cosmic-pi-deprecated/MainBoard-hardware/README.md

# MainBoard-hardware
Mainboard for Arduino DUE based versions
