cosmic-pi-deprecated/MainBoard-hardware/ProductionBOM Cosmic Pi Main Board 181017.xlsx

Qty | Value | Parts | Package | Tolerance | Wattage | Voltage Rating | Manufacturer | MPN | Description | Device | Side | Mounting
1 | 22-23-2051 | 22-23-2051 | H5-2.54 |  |  |  | Harwin | M20-9990546 | 5 Pin 2.54mm pitch male header |  | Top | TH
1 | 0 | R1 | R0603 | 1% | 0.1W |  |  |  | RESISTOR, European symbol | R-EU_R0603 | Bottom | SMD
1 | 10 | R2 | R0603 | 1% | 0.1W |  |  |  | RESISTOR, European symbol | R-EU_R0603 | Bottom | SMD
6 | 100k | R11, R12, R37, R38, R41, R42 | R0603 | 1% | 0.1W |  |  |  | RESISTOR, European symbol | R-EU_R0603 | Bottom | SMD
18 | 100n | C3, C4, C5, C7, C12, C13, C14, C15, C16, C18, C21, C23, C29, C33, C35, C38, C41, C42 | C0603 | 10% |  | 100 |  |  | CAPACITOR, European symbol | C-EUC0603 | Bottom | SMD
10 | 10k | R4, R5, R9, R10, R24, R34, R35, R36, R39, R40 | R0603 | 1% | 0.1W |  |  |  | RESISTOR, European symbol | R-EU_R0603 | Bottom | SMD
8 | 10n | C6, C11, C17, C25, C26, C27, C36, C39 | C0603 | 10% |  | 10 |  |  | CAPACITOR, European symbol | C-EUC0603 | Bottom | SMD
2 | 10u | C9, C10 | C0603 | 10% |  |  |  |  | CAPACITOR, European symbol | C-EUC0603 | Bottom | SMD
2 | 150uH | L2, L9 | L1812 |  |  |  | Bourns | CM453232-151KL | INDUCTOR, European symbol | L-EUL1812 | Bottom | SMD
2 | 15k | R18, R32 | R0603 | 1% | 0.1W |  |  |  | RESISTOR, European symbol | R-EU_R0603 | Bottom | SMD
8 | 1M | R13, R14, R15, R21, R25, R26, R27, R30 | R0603 | 1% | 1/16W |  |  |  | RESISTOR, European symbol | R-EU_R0603 | Bottom | SMD
4 | 1n | C28, C34, C43, C44 | C0603 | 10% |  | 10 |  |  | CAPACITOR, European symbol | C-EUC0603 | Bottom | SMD
2 | 1u | C20, C32 | C0603 | -20/+80% |  | 10 |  |  | CAPACITOR, European symbol | C-EUC0603 | Bottom | SMD
2 | 200k | R23, R33 | R0603 | 5% | 1/16W |  |  |  | RESISTOR, European symbol | R-EU_R0603 | Bottom | SMD
5 | 220n | C19, C22, C30, C37, C40 | C0603 | 10% |  | 10 |  |  | CAPACITOR, European symbol | C-EUC0603 | Bottom | SMD
2 | 24.9k | R19, R29 | R0603 | 1% | 0.2W |  |  | ERJP03F24R9V | RESISTOR, European symbol | R-EU_R0603 | Bottom | SMD
2 | 32.4k | R22, R31 | R0603 | 1% | 0.1W |  |  | ERJ3EKF3242V | RESISTOR, European symbol | R-EU_R0603 | Bottom | SMD
4 | 330R | R3, R6, R7, R8 | R0603 | 5% | 1/16W |  |  |  | RESISTOR, European symbol | R-EU_R0603 | Bottom | SMD
1 | 4.7u | C8 | C0603 | 10% |  | 10 |  |  | CAPACITOR, European symbol | C-EUC0603 | Bottom | SMD
2 | 40 | R16, R17 | R0603 | 5% | 1/16W |  |  | ERJ3EKF40R2V | RESISTOR, European symbol | R-EU_R0603 | Bottom | SMD
2 | 47n | C24, C31 | C0603 | 10% |  | 100 |  | C1608X7S2A473K080AB | CAPACITOR, European symbol | C-EUC0603 | Bottom | SMD
1 | 47nH | L1 | INDC1608X90N |  |  |  | EPCOS | B82496C3470J000 | INDUCTOR, 47NH 270MA 5% | B82496C3470J | Bottom | SMD
2 | 4p-2.54 | J1, J2 | H4-2.54 |  |  |  | Harwin | M20-7820446 | 320030017 | DIP-BLACK-FEMALE-HEADER-VERT(4P-2.54) | Top | SMD
1 | 5-1814400-1 | J5 | TE_5-1814400-1 |  |  |  | TE Connectivity | 5-1814400-1 | Conn SMA RCP 0Hz to 3GHz 50Ohm Solder RA Thru-Hole Gold Over Nickel Over Copper | 5-1814400-1 | Top | TH
5 | 600R/100MHz | L4, L5, L6, L7, L8 | 1206 |  |  |  | Wurth | 74279218 | SMD EMI Suppression Ferrite Beads WE-CBF | WE-CBF-74279218_1206 | Bottom | SMD
3 | 74AUC1G00DBV | IC1, IC5, IC6 | SOT23-5 |  |  |  | Texas Instruments | SN74AHCT1G00DBVR | 2-input NAND gate | 74AUC1G00DBV | Bottom | SMD
2 | 806 | R20, R28 | R0603 | 1% | 0.1W |  | Farnell | 2670898 | RESISTOR, European symbol | R-EU_R0603 | Bottom | SMD
2 | BAT46WH | BAT46WH1, BAT46WH2 | SOD123F |  |  |  | Nexperia | BAT46WH | Single Schottky barrier diodeSingle planar Schottky barrier diode with an integrated guard ring for stress protection, | BAT46WH | Bottom | SMD
2 | BSS123 | Q1, Q2 | SOT23 |  |  |  | Diodes Zetex | BSS123-7-F | N-CHANNEL MOS FET | BSS123 | Bottom | SMD
1 | DUE(NORMAL) | DUE1 | DUE(NORMAL) |  |  |  | Harwin | 5 of M20-9990845, 1 of M20-9991046 | Note - this 'part is actually 6 sets of pin headers for the Arduino DUE. The 40 pin header is omitted. | DUE(NORMAL) | Bottom | TH
1 | L-710A8GE/1I1GD-RV | D1 | 2X02 |  |  |  | Kingbright | L-710A8GE/1I1GD-RV | PIN HEADER | KINGBRITET1 | Top | TH
1 | L76-M33 | U1 | CAPCAV110P970X1010X250-18N |  |  |  | Quectel | L76-M33 | GPS Receiver 1575.42MHz 2.5V/3.3V 18-Pin | L76-M33 | Bottom | SMD
3 | LM555D | IC2, IC3, IC4 | SO08 |  |  |  | Texas Instruments | TLC555ID | TIMER | LM555D | Bottom | SMD
1 | LPS25H | IC$1 | LPS25H |  |  |  | ST Micro | LPS25HBTR | ST-Micro Piezoresistive pressure sensor | LPS25H | Bottom | SMD
1 | LSM303D | U2 | LGA16L |  |  |  | ST Micro | LSM303DTR |  | LSM303D | Bottom | SMD
2 | MAX1932 | U5, U6 | TQFN-12 |  |  |  | Maxim | MAX1932ETC+ |  | MAX1932 | Bottom | SMD
1 | MAX991ESA+ | IC$3 | SOIC-8 |  |  |  | Maxim | MAX991ESA+ |  | MAX991ESA+ | Bottom | SMD
1 | SI7006A20 | IC$2 | 3X3DFN |  |  |  | Silicon Labs | Si7006-A20-IM |  | SI7006A20 | Bottom | SMD
120 | Total
91 | SMD
11 | TH
4 | Packages with concealed pads
84 | Passives
