cosmic-pi-deprecated/MainBoard-hardware/Cosmic Pi Main Board V2.5 OHL no logo.pdf

A

A

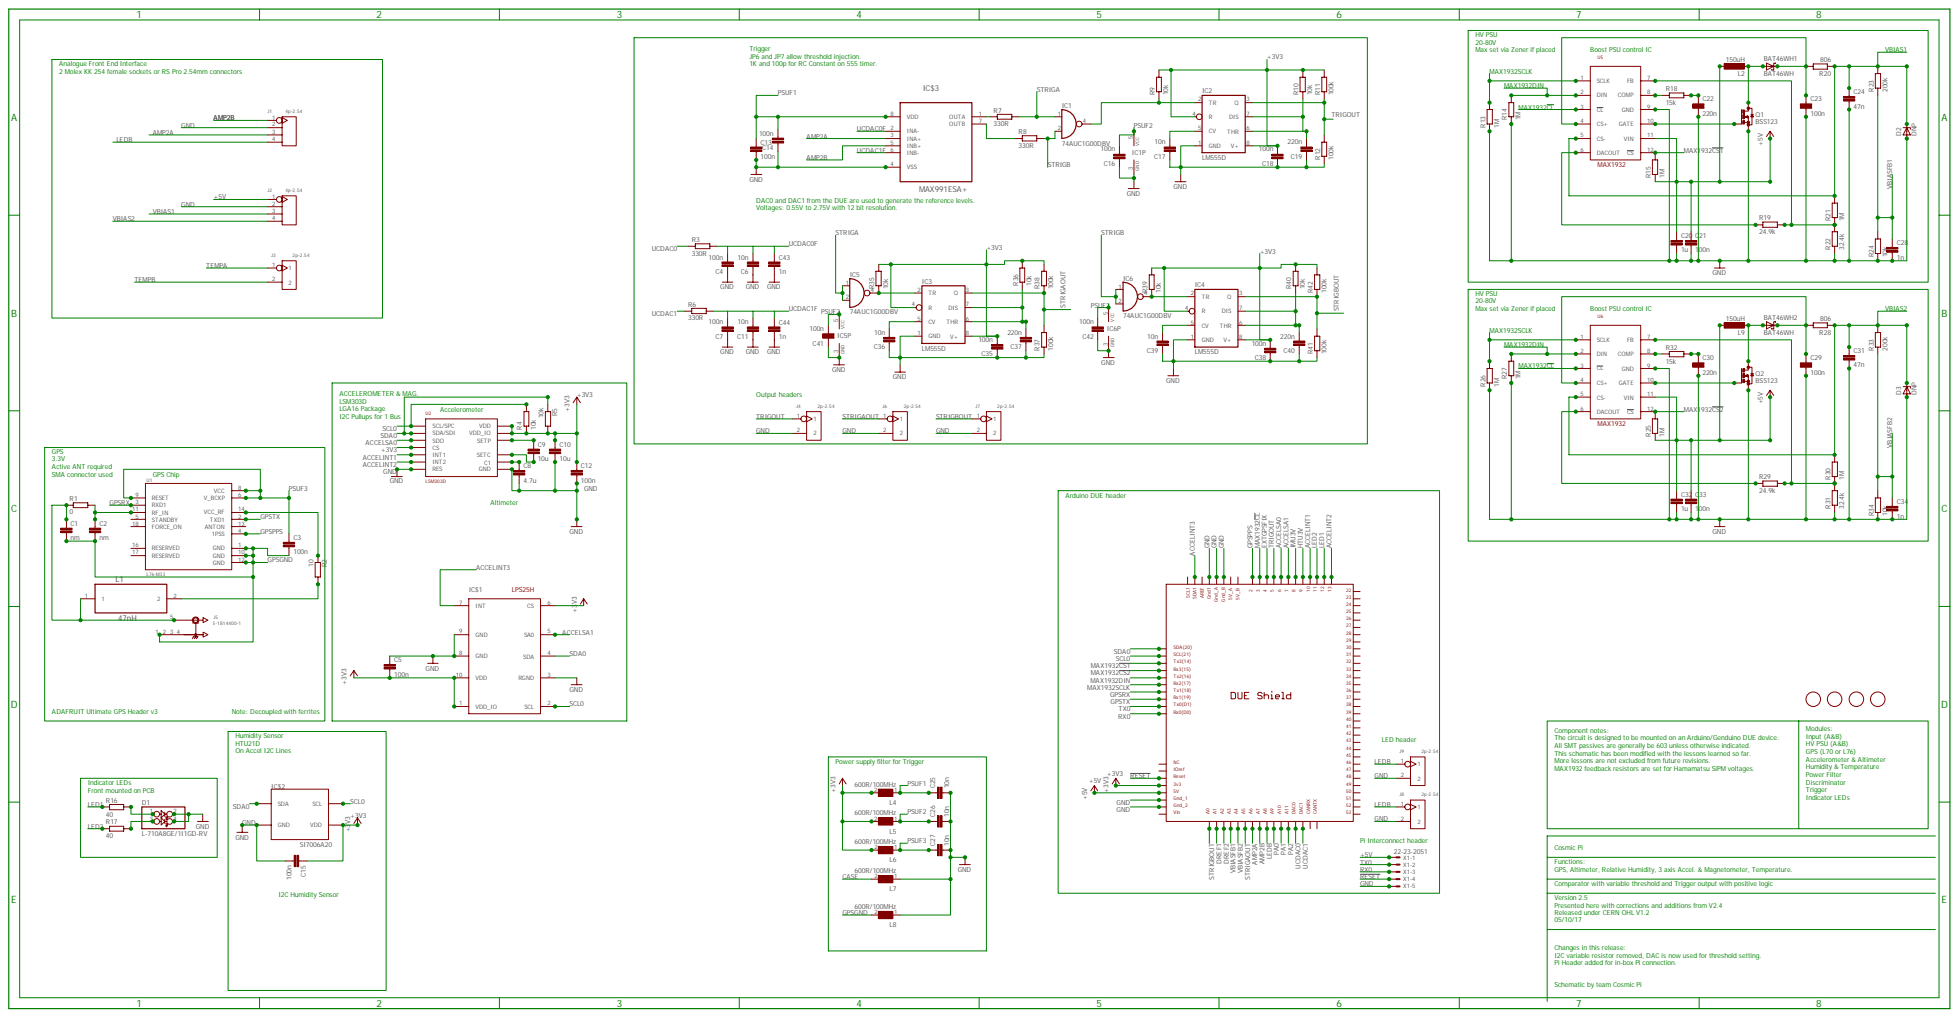
[picture p1: page 1]

HV PSU
Max set via Zener if placed

Trigger
JP6 and JP7 allow threshold injection.
1K and 100p for RC Constant on 555 timer.

Boost PSU control IC

Analogue Front End Interface
2 Molex KK 254 female sockets or RS Pro 2.54mm connectors

DAC0 and DAC1 from the DUE are used to generate the reference levels.
Voltages: 0.55V to 2.75V with 12 bit resolution.

ADAFRUIT Ultimate GPS Header v3

Note: Decoupled with ferrites

Component notes:
The circuit is designed to be mounted on an Arduino/Genduino DUE device.
All SMT passives are generally be 603 unless otherwise indicated.
This schematic has been modified with the lessons learned so far.
More lessons are not excluded from future revisions.
MAX1932 feedback resistors are set for Hamamatsu SiPM voltages.

Power supply filter for Trigger

Cosmic Pi
Functions:
GPS, Altimeter, Relative Humidity, 3 axis Accel. & Magnetometer, Temperature.
Comparator with variable threshold and Trigger output with positive logic
Version 2.5
Presented here with corrections and additions from V2.4
Released under CERN OHL V1.2

Changes in this release:
I2C variable resistor removed, DAC is now used for threshold setting.
Pi Header added for in-box Pi connection.

Schematic by team Cosmic Pi
