cosmic-pi-deprecated/MainBoard-hardware/Cosmic Pi Main Board V2.5 OHL no logo.brd

## EAGLE design Cosmic Pi Main Board V2.5 OHL no logo.brd (2017-10-26)

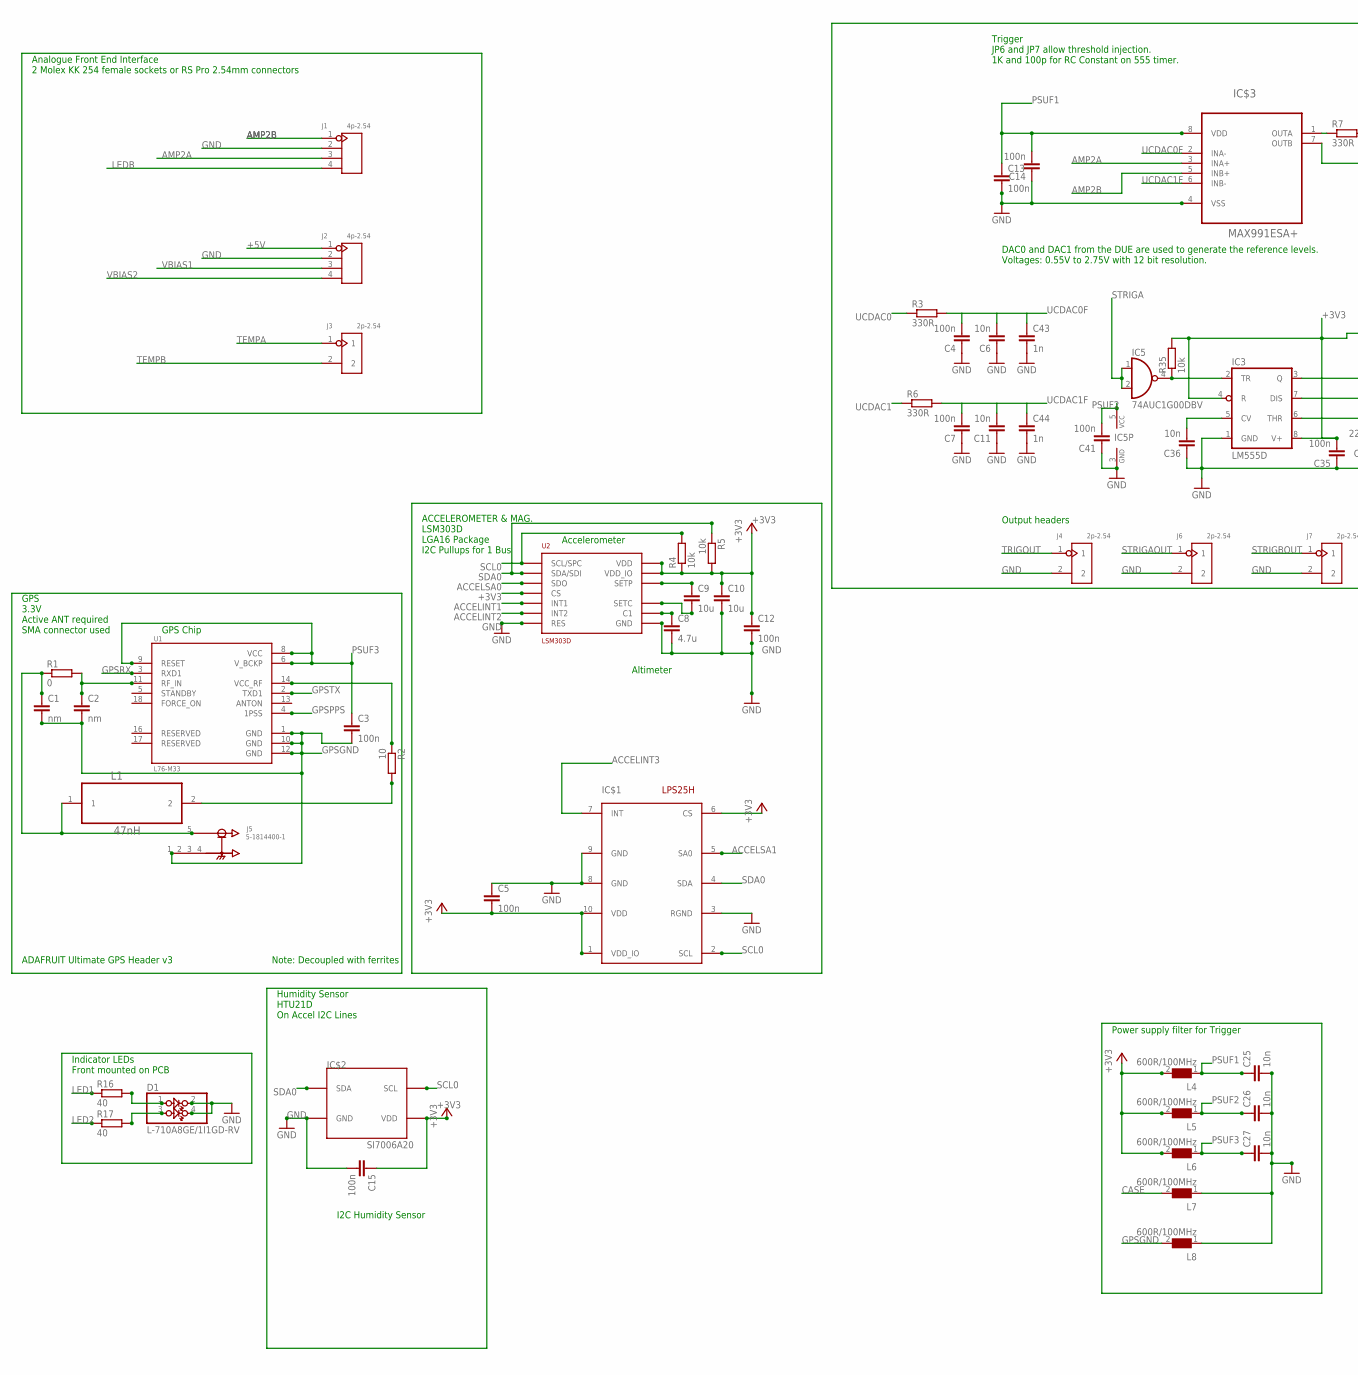
[picture p2: schematic Cosmic Pi Main Board V2.5 OHL no logo.sch, part in row 1, column 1]

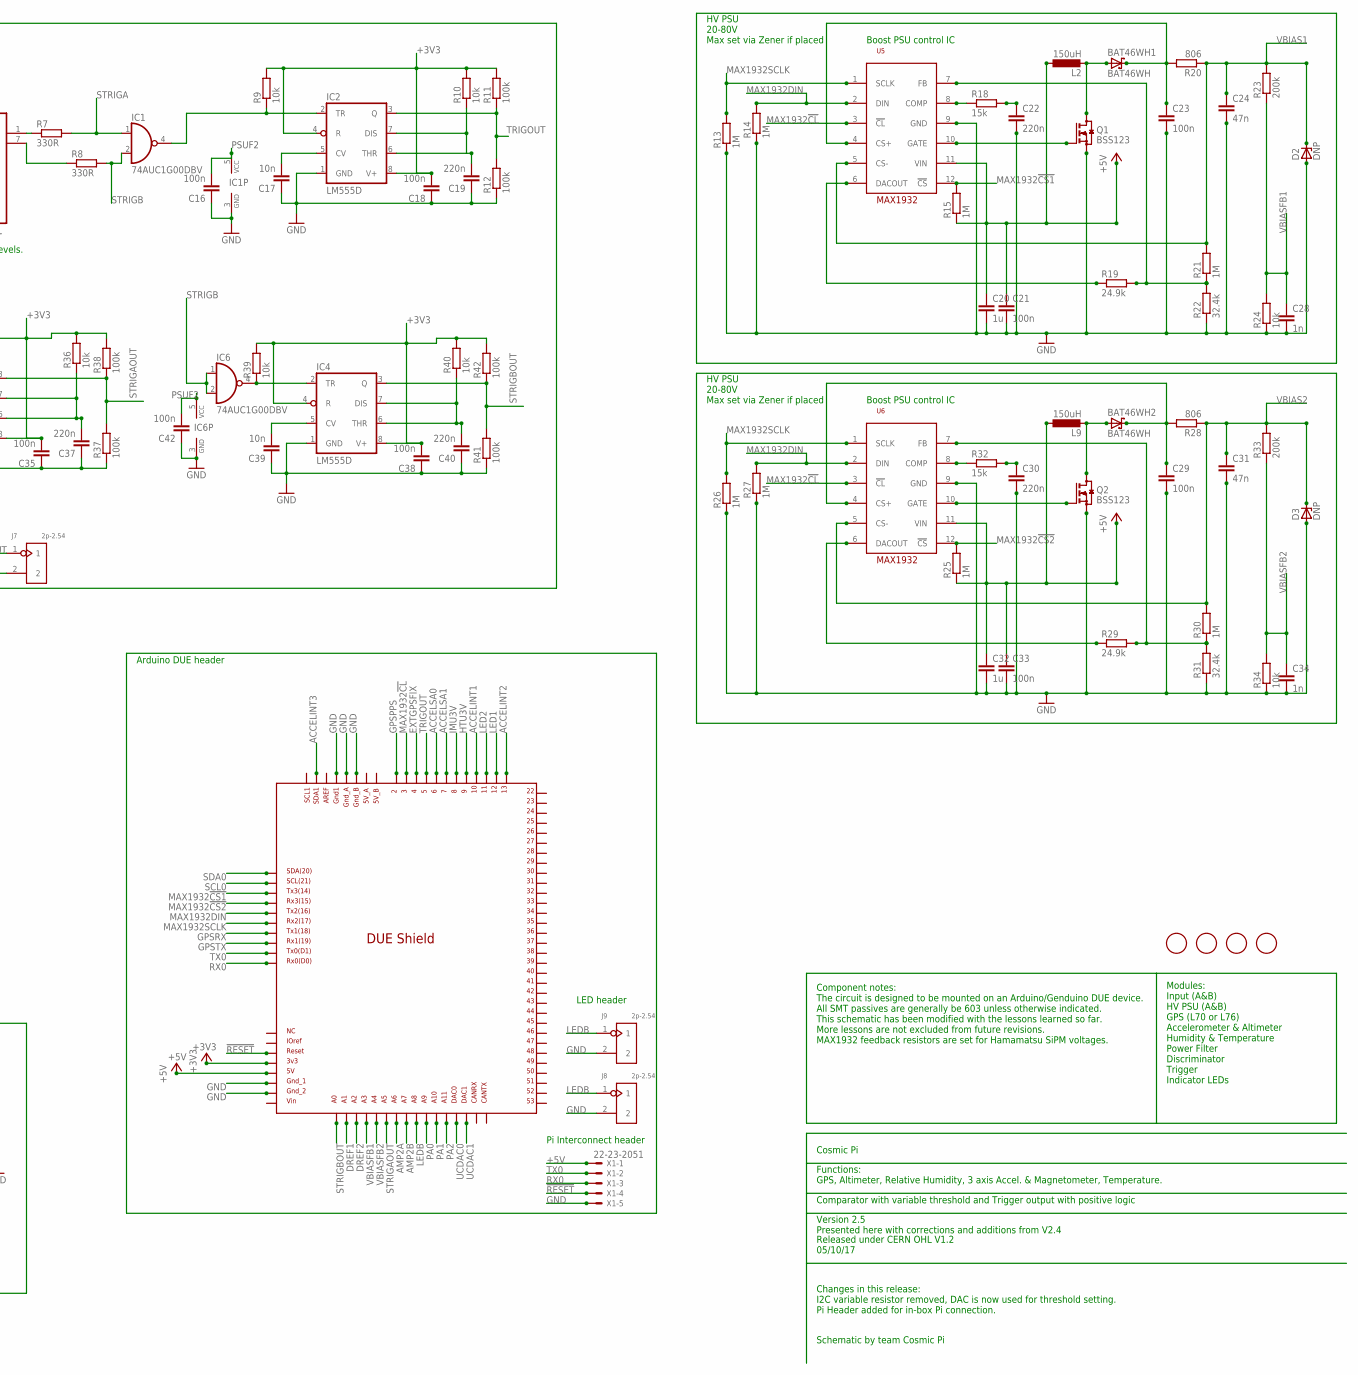
[picture p3: schematic Cosmic Pi Main Board V2.5 OHL no logo.sch, part in row 1, column 2]

Parts:
BAT46WH1, BAT46WH2: BAT46WH; SOD123F
C1, C2: nm; C0603
C3, C4, C5, C7, C12, C13, C14, C15, C16, C18, C21, C23, C29, C33, C35, C38, C41, C42: 100n; C0603
C6, C11, C17, C25, C26, C27, C36, C39: 10n; C0603
C8: 4.7u; C0603
C9, C10: 10u; C0603
C19, C22, C30, C37, C40: 220n; C0603
C20, C32: 1u; C0603
C24, C31: 47n; C0603
C28, C34, C43, C44: 1n; C0603
D1: L-710A8GE/1I1GD-RV; 2X02
D2, D3: DNP; SOT23
DUE1: DUE(NORMAL)
IC1, IC5, IC6: 74AUC1G00DBV; SOT23-5
IC2, IC3, IC4: LM555D; SO08
IC$1: LPS25H
IC$2: SI7006A20; 3X3DFN
IC$3: MAX991ESA+; SOIC-8
J1, J2: 4p-2.54; H4-2.54
J3, J4, J6, J7, J8, J9: 2p-2.54; H2-2.54
J5: 5-1814400-1; TE_5-1814400-1
L1: 47nH; INDC1608X90N
L2, L9: 150uH; L1812
L4, L5, L6, L7, L8: 600R/100MHz; 1206
Q1, Q2: BSS123; SOT23
R1: 0; R0603
R2: 10; R0603
R3, R6, R7, R8: 330R; R0603
R4, R5, R9, R10, R24, R34, R35, R36, R39, R40: 10k; R0603
R11, R12, R37, R38, R41, R42: 100k; R0603
R13, R14, R15, R21, R25, R26, R27, R30: 1M; R0603
R16, R17: 40; R0603
R18, R32: 15k; R0603
R19, R29: 24.9k; R0603
R20, R28: 806; R0603
R22, R31: 32.4k; R0603
R23, R33: 200k; R0603
U1: L76-M33; CAPCAV110P970X1010X250-18N
U2: LSM303D; LGA16L
U5, U6: MAX1932; TQFN-12
U$1, U$2, U$3, U$4: FIDUCIAL; FIDUCIAL_1MM
X1: 22-23-2051

Connections:
!RESET: DUE1.RESET, X1.4
+3V3: C5.2, C10.1, C12.1, C15.1, C18.2, C35.2, C38.2, DUE1.3V3, IC2.4 (R), IC2.8 (V+), IC3.4 (R), IC3.8 (V+), IC4.4 (R), IC4.8 (V+), IC$1.1 (VDD_IO), IC$1.6 (CS), IC$1.10 (VDD), IC$2.P$5 (VDD), L4.2, L5.2, L6.2, R4.1, R5.2, R9.2, R10.2, R11.2, R35.2, R36.2, R38.2, R39.2, R40.2, R42.2, U2.P$1 (VDD_IO), U2.P$8 (CS), U2.P$14 (VDD)
+5V: C20.1, C21.1, C32.1, C33.1, DUE1.5V, J2.1, L2.1, L9.1, R15.1, R25.1, U5.11 (VIN), U6.11 (VIN), X1.1
ACCELINT1: DUE1.10, U2.P$11 (INT1)
ACCELINT2: DUE1.13, U2.P$9 (INT2)
ACCELINT3: DUE1.SDA1, IC$1.7 (INT)
ACCELSA0: DUE1.6, U2.P$7 (SDO)
ACCELSA1: DUE1.7, IC$1.5 (SA0)
AMP2A: DUE1.A6, IC$3.3 (INA+), J1.3
AMP2B: DUE1.A7, IC$3.5 (INB+), J1.1
CASE: L7.2
DREF1: DUE1.A1
DREF2: DUE1.A2
EXTGPSFIX: DUE1.4
GND: C4.1, C5.1, C6.1, C7.1, C8.2, C10.2, C11.1, C12.2, C13.2, C14.1, C15.2, C16.1, C17.1, C18.1, C19.1, C20.2, C21.2, C22.2, C23.2, C24.2, C25.2, C26.2, C27.2, C28.2, C29.2, C30.2, C31.2, C32.2, C33.2, C34.2, C35.1, C36.1, C37.1, C38.1, C39.1, C40.1, C41.1, C42.1, C43.2, C44.2, D1.2, D1.4, D2.1 (A), D3.1 (A), DUE1.GND1, DUE1.GND_1, DUE1.GND_2, DUE1.GND_A, DUE1.GND_B, IC1.3 (GND), IC2.1 (GND), IC3.1 (GND), IC4.1 (GND), IC5.3 (GND), IC6.3 (GND), IC$1.3 (RGND), IC$1.8 (GND), IC$1.9 (GND), IC$2.P$2 (GND), IC$3.4 (VSS), J1.2, J2.2, J4.2, J6.2, J7.2, J8.2, J9.2, L7.1, L8.1, Q1.2 (S), Q2.2 (S), R12.1, R13.1, R14.1, R22.1, R24.1, R26.1, R27.1, R31.1, R34.1, R37.1, R41.1, U2.P$5 (GND), U2.P$10 (RES), U2.P$12 (GND), U2.P$13 (GND), U2.P$16 (GND), U5.9 (GND), U6.9 (GND), X1.5
GPSGND: C1.2, C2.2, C3.2, J5.1 (GND), L8.2, U1.1 (GND), U1.10 (GND), U1.12 (GND)
GPSPPS: DUE1.2, U1.4 (1PSS)
GPSRX: DUE1.TX1, U1.3 (RXD1)
GPSTX: DUE1.RX1, U1.2 (TXD1)
HTU3V: DUE1.9
IMU3V: DUE1.8
LED1: DUE1.12, R16.1
LED2: DUE1.11, R17.1
LEDB: DUE1.A8, J1.4, J8.1, J9.1
MAX1932!CL: DUE1.3, U5.3 (!CL), U6.3 (!CL)
MAX1932!CS1: DUE1.TX3, R15.2, U5.12 (!CS)
MAX1932!CS2: DUE1.RX3, R25.2, U6.12 (!CS)
MAX1932DIN: DUE1.TX2, R14.2, R27.2, U5.2 (DIN), U6.2 (DIN)
MAX1932SCLK: DUE1.RX2, R13.2, R26.2, U5.1 (SCLK), U6.1 (SCLK)
unnamed: IC$3.1 (OUTA), R7.1
unnamed: IC$3.7 (OUTB), R8.1
unnamed: C17.2, IC2.5 (CV)
unnamed: C19.2, IC2.6 (THR), IC2.7 (DIS), R10.1
unnamed: C36.2, IC3.5 (CV)
unnamed: Q2.1 (G), U6.10 (GATE)
unnamed: BAT46WH2.2 (A), L9.2, Q2.3 (D)
unnamed: BAT46WH2.1 (K), C29.1, R28.2, U6.4 (CS+)
unnamed: R29.1, U6.6 (DACOUT)
unnamed: R32.1, U6.8 (COMP)
unnamed: C30.1, R32.2
unnamed: R29.2, R30.1, R31.2, U6.7 (FB)
unnamed: C37.2, IC3.6 (THR), IC3.7 (DIS), R36.1
unnamed: IC1.4 (O), IC2.2 (TR), R9.1
unnamed: Q1.1 (G), U5.10 (GATE)
unnamed: C39.2, IC4.5 (CV)
unnamed: C40.2, IC4.6 (THR), IC4.7 (DIS), R40.1
unnamed: IC4.2 (TR), IC6.4 (O), R39.1
unnamed: IC3.2 (TR), IC5.4 (O), R35.1
unnamed: BAT46WH1.2 (A), L2.2, Q1.3 (D)
unnamed: BAT46WH1.1 (K), C23.1, R20.2, U5.4 (CS+)
unnamed: R19.2, R21.1, R22.2, U5.7 (FB)
unnamed: C1.1, J5.5 (SIG), L1.1, R1.1
unnamed: R19.1, U5.6 (DACOUT)
unnamed: R18.1, U5.8 (COMP)
unnamed: C22.1, R18.2
unnamed: C9.1, U2.P$3 (SETP)
unnamed: C9.2, U2.P$2 (SETC)
unnamed: C8.1, U2.P$15 (C1)
unnamed: L1.2, R2.2
unnamed: R2.1, U1.14 (VCC_RF)
unnamed: C2.1, R1.2, U1.11 (RF_IN)
unnamed: D1.1, R16.2
unnamed: D1.3, R17.2
PA0: DUE1.A9
PA1: DUE1.A10
PA2: DUE1.A11
PSUF1: C13.1, C14.2, C25.1, IC$3.8 (VDD), L4.1
PSUF2: C16.2, C26.1, C41.2, C42.2, IC1.5 (VCC), IC5.5 (VCC), IC6.5 (VCC), L5.1
PSUF3: C3.1, C27.1, L6.1, U1.6 (V_BCKP), U1.8 (VCC), U1.9 (RESET)
RX0: DUE1.RX0, X1.3
SCL0: DUE1.SCL, IC$1.2 (SCL), IC$2.P$6 (SCL), R4.2, U2.P$4 (SCL/SPC)
SDA0: DUE1.SDA, IC$1.4 (SDA), IC$2.P$1 (SDA), R5.1, U2.P$6 (SDA/SDI)
STRIGA: IC1.1 (I0), IC5.1 (I0), IC5.2 (I1), R7.2
STRIGAOUT: DUE1.A5, IC3.3 (Q), J6.1, R37.2, R38.1
STRIGB: IC1.2 (I1), IC6.1 (I0), IC6.2 (I1), R8.2
STRIGBOUT: DUE1.A0, IC4.3 (Q), J7.1, R41.2, R42.1
TEMPA: J3.1
TEMPB: J3.2
TRIGOUT: DUE1.5, IC2.3 (Q), J4.1, R11.1, R12.2
TX0: DUE1.TX0, X1.2
UCDAC0: DUE1.DAC0, R3.1
UCDAC0F: C4.2, C6.2, C43.1, IC$3.2 (INA-), R3.2
UCDAC1: DUE1.DAC1, R6.1
UCDAC1F: C7.2, C11.2, C44.1, IC$3.6 (INB-), R6.2
VBIAS1: C24.1, D2.3 (C), J2.3, R20.1, R21.2, R23.2, U5.5 (CS-)
VBIAS2: C31.1, D3.3 (C), J2.4, R28.1, R30.2, R33.2, U6.5 (CS-)
VBIASFB1: C28.1, DUE1.A3, R23.1, R24.2
VBIASFB2: C34.1, DUE1.A4, R33.1, R34.2

Notes on the sheet:
Cosmic Pi
Functions: GPS, Altimeter, Relative Humidity, 3 axis Accel. & Magnetometer, Temperature.
Comparator with variable threshold and Trigger output with positive logic
Version 2.5 Presented here with corrections and additions from V2.4
Released under CERN OHL V1.2 05/10/17
Schematic by team Cosmic Pi
HV PSU 20-80V Max set via Zener if placed
GPS 3.3V Active ANT required SMA connector used
ACCELEROMETER & MAG. LSM303D LGA16 Package I2C Pullups for 1 Bus
ADAFRUIT Ultimate GPS Header v3
Trigger JP6 and JP7 allow threshold injection. 1K and 100p for RC Constant on 555 timer.
Power supply filter for Trigger
Arduino DUE header
Humidity Sensor HTU21D On Accel I2C Lines
Indicator LEDs Front mounted on PCB
Modules: Input (A&B) HV PSU (A&B) GPS (L70 or L76) Accelerometer & Altimeter Humidity & Temperature Power Filter Discriminator Trigger Indicator LEDs
Accelerometer
Altimeter
GPS Chip
I2C Humidity Sensor
Boost PSU control IC
Component notes: The circuit is designed to be mounted on an Arduino/Genduino DUE device. All SMT passives are generally be 603 unless otherwise indicated. This schematic has been modified with the lessons learned so far. More lessons are not excluded from future revisions. MAX1932 feedback resisto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
Analogue Front End Interface 2 Molex KK 254 female sockets or RS Pro 2.54mm connectors
Note: Decoupled with ferrites
Changes in this release: I2C variable resistor removed, DAC is now used for threshold setting. Pi Header added for in-box Pi connection.
DAC0 and DAC1 from the DUE are used to generate the reference levels. Voltages: 0.55V to 2.75V with 12 bit resolution.
Pi Interconnect header
Output headers
LED header

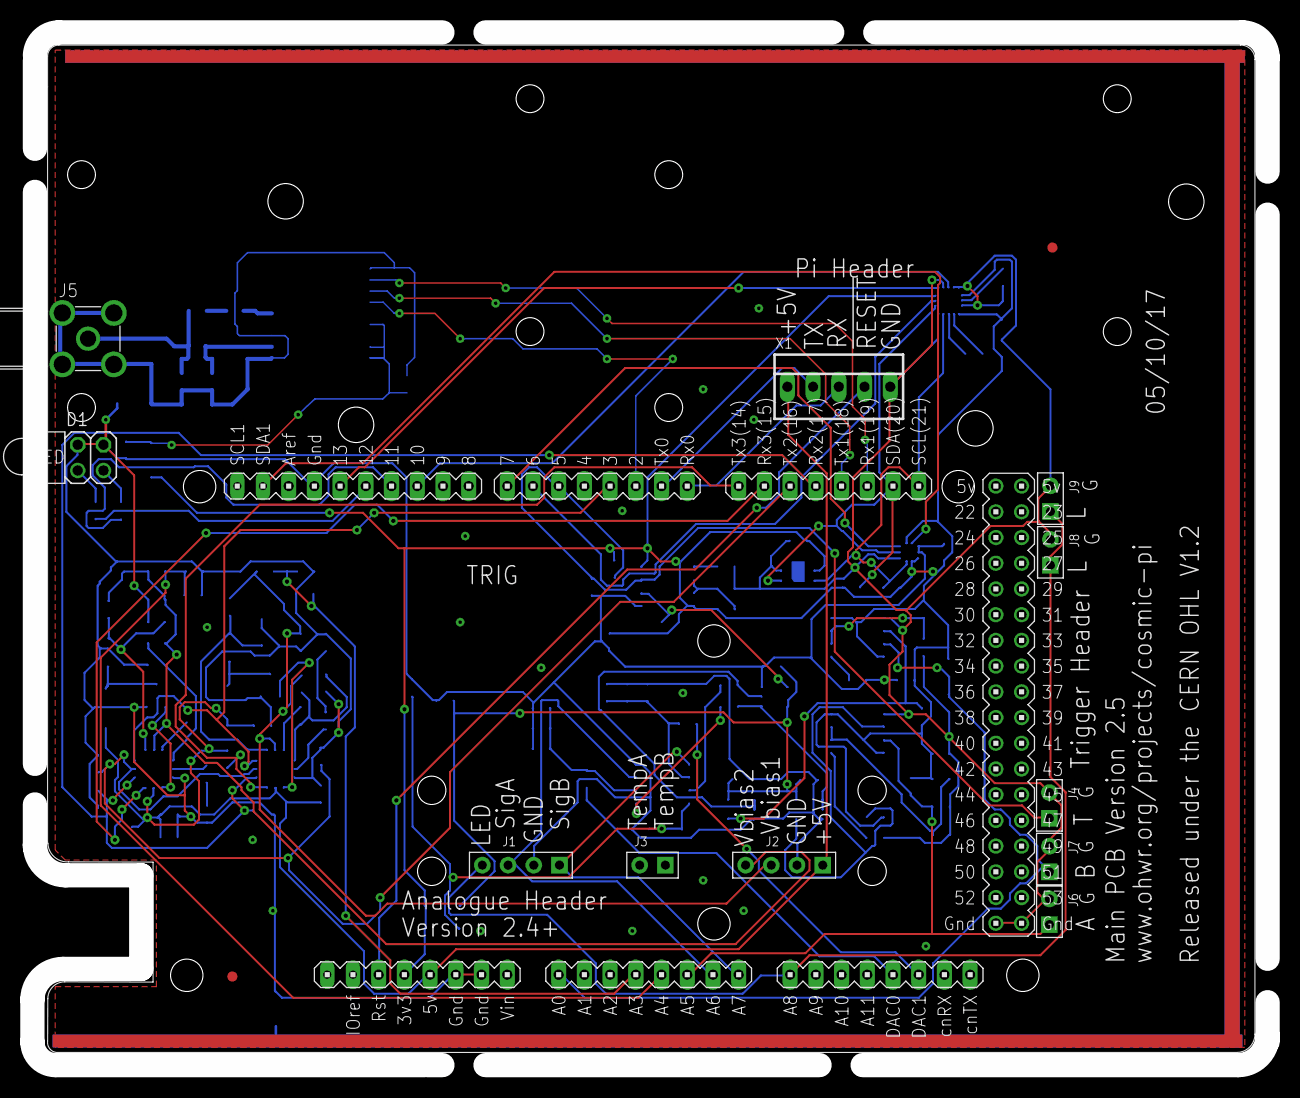
[picture p4: board Cosmic Pi Main Board V2.5 OHL no logo.brd from above]

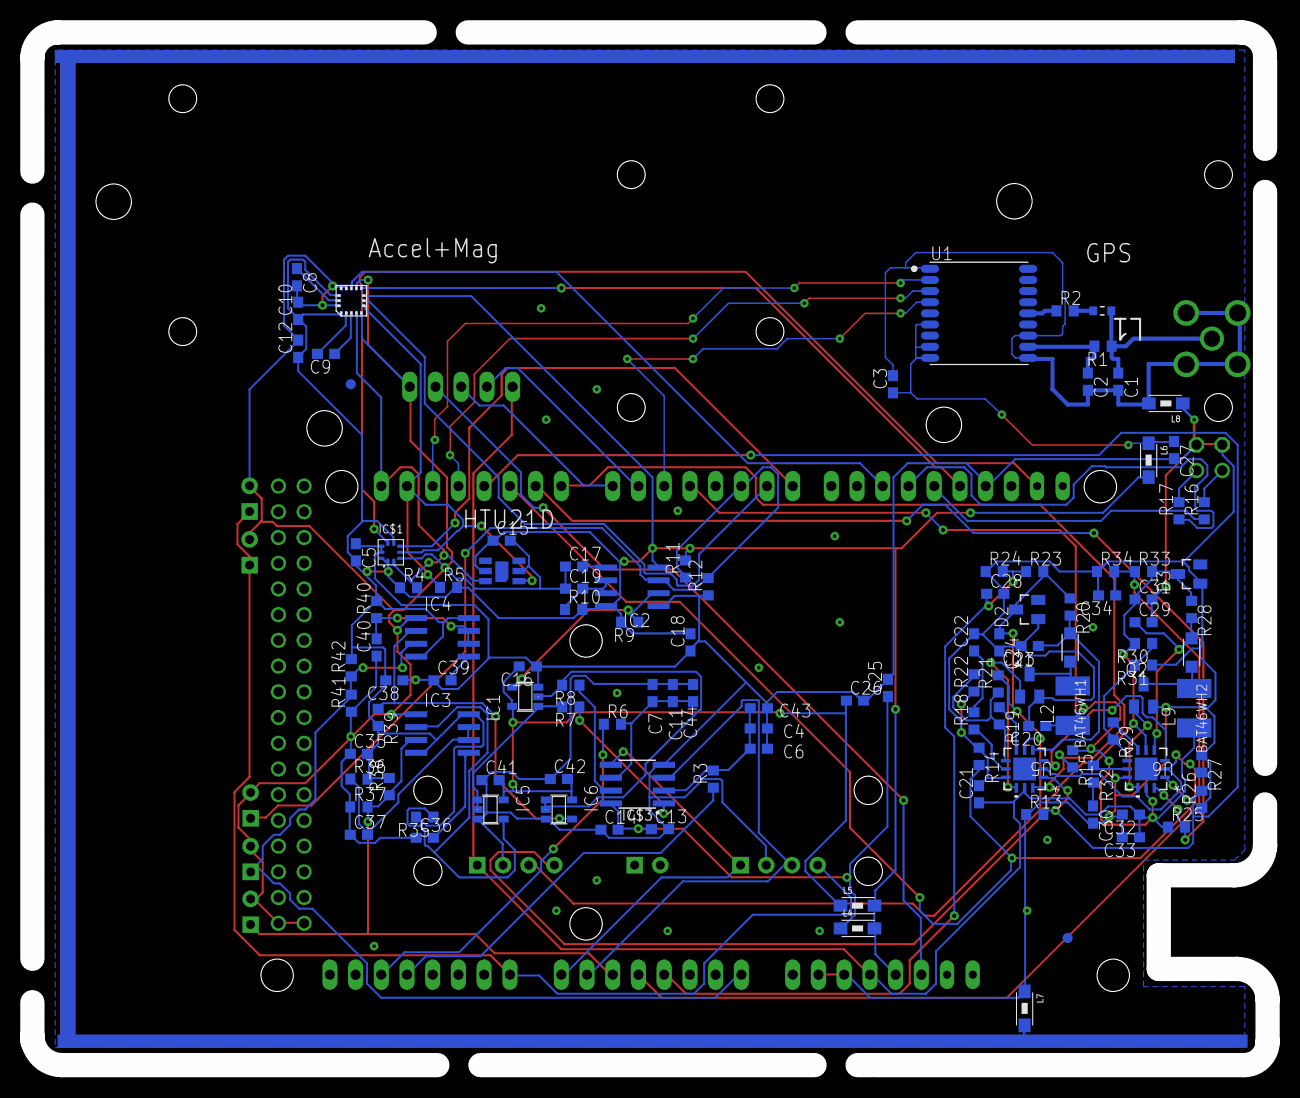
[picture p5: board Cosmic Pi Main Board V2.5 OHL no logo.brd from below]

Board: 2 copper layers, 122.0 x 102.0 mm, 129 parts (115 on the bottom side), 77 nets.
