cosmic-pi-deprecated/MainBoard-hardware/(commit log)

2017-09-18 Design files for intermediate main board (still uses DUE)
    [Cosmic Pi Main Board V2.4 OHWR.brd, Cosmic Pi Main Board V2.4 OHWR.sch]
2017-10-26 Updated V2.5 with pi mini-header
    [Cosmic Pi Main Board V2.5 OHL no logo.brd, Cosmic Pi Main Board V2.5 OHL no logo.sch, ProductionBOM Cosmic Pi Main Board 181017.xlsx]
2017-11-20 Assembly guide - also covers V2.5 Analogue PCB
