cosmic-pi-deprecated/MainBoard-hardware/(notices)

Notices in the files:
Cosmic Pi Main Board V2.5 OHL no logo.brd:
Released under the CERN OHL V1.2
